ruipgb/Greenhouse-Temperature-LED-Control/Greenhouse-Temperature-LED-Control-Report.pdf

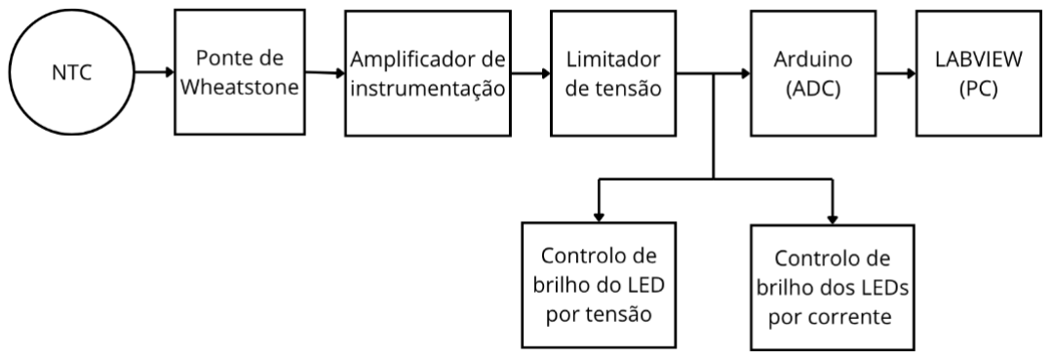
[picture p1: figure]
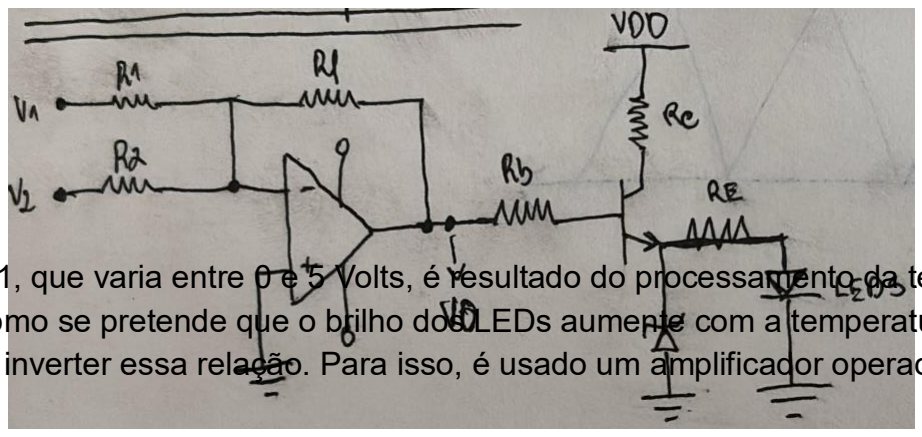
[picture p2: figure]

Figura 2- Circuito de controlo do brilho dos LEDs (controlo por corrente)

Neste relatório irá ser apresentado o desenvolvimento de um sistema de monitorização e controlo da temperatura de uma estufa em que com a alteração da temperatura altera também o brilho de vários LEDs da mesma forma.

Ao longo deste relatório irão ser descritos em separados os vários circuitos utilizados, e expostos por partes, sendo estas partes o dimensionamento, ou seja, os cálculos necessários para concluir os circuitos, a simulação, para verificar o comportamento do circuito de forma segura, experimentação, portanto, os resultados obtidos em laboratório apos a montagem do circuito, e finalmente, a conclusão, onde serão expostas comparações entre as partes anteriormente descritas.

### 2. Diagrama geral

Este projeto está dividido em vários blocos, sendo os novos para este relatório, o controlo de brilho dos LEDs por corrente, onde se inverte e soma ao sinal durante condicionamento de sinal e amplifica-se a corrente, o controlo de brilho do LED por tensão, onde se compara o sinal que sai do amplificador de instrumentação com uma onda triangular para criar uma onda PWM e controlar o seu duty cycle, e finalmente, o LABVIEW, onde ligando o arduino ao PC por porta série pode-se observar um gráfico da temperatura em função do tempo recorrendo às funcionalidades do LABVIEW.

Figura 1 – Diagrama geral

### 3. Controlo de brilho dos LEDs por corrente

a. Circuito adotado

O circuito implementado tem como objetivo controlar o brilho dos LEDs através da regulação da corrente que os atravessa, com base numa tensão de entrada proveniente do Amplificador de instrumentação, designada de VAI = V1.

A tensão V1, que varia entre 0 e 5 Volts, é resultado do processamento da temperatura medida. Como se pretende que o brilho dos LEDs aumente com a temperatura, foi necessário inverter essa relação. Para isso, é usado um amplificador operacional

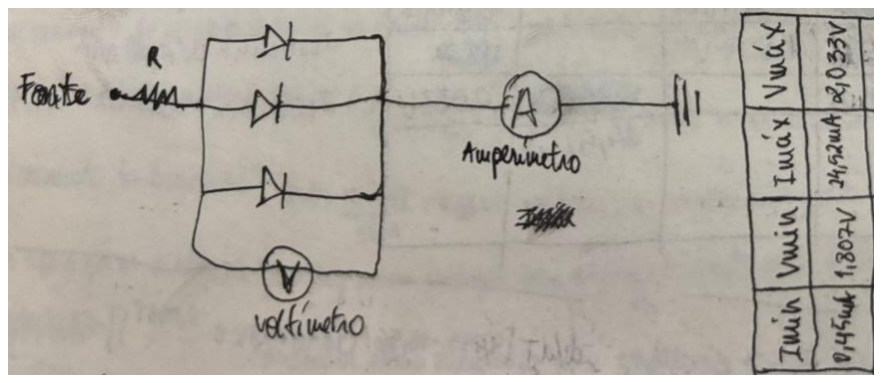
[picture p3: figure]

Figura 3- Circuito de teste e valores medidos

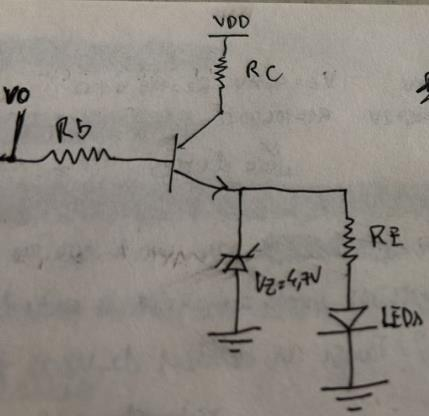
[picture p4: figure]
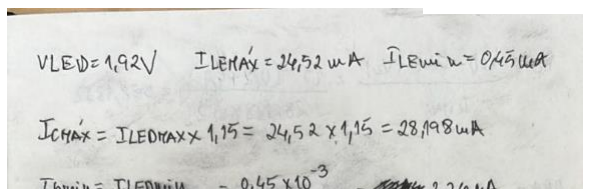
[picture p5: figure]
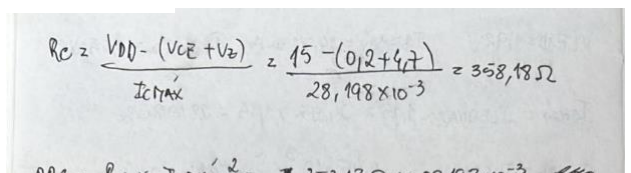
[picture p6: figure]

Figura 4- circuito controlador de corrente

(TL082) em somador inversor, que converte o intervalo [0 V, 5 V] em [V0A = 2,72 V, V0B = 8 V].

A tensão V0 é a tensão de entrada da segunda parte do circuito responsável por controlar a corrente ILED que atravessa os LEDs. Este circuito atua como controlador de corrente, garantindo que a corrente nos LEDs seja proporcional à tensão V0.

À medida que a temperatura aumenta, VAI diminui, o que leva a um aumento de V0 e, consequentemente, da corrente ILED, aumentando o brilho dos LEDs.

b. Análise dos LEDs

Nesta fase, foi medida a corrente mínima (ILEDmin) e a corrente máxima (ILEDmax) em que os LEDs ficavam com pouco brilho e com bastante brilho, respetivamente.

Para isso, foi montado o seguinte circuito de teste e medidos os valores:

Estes valores definem os limites de operação desejados para o circuito principal.

c. Controlador de corrente (Limitador de tensão – amplificação de corrente)
i. Dimensionamento

Com base nos valores medidos para ILEDmin = 0,45 mA e ILEDmax = 24,52 mA, dimensionou-se os componentes do circuito de controlo de corrente.

Esta parte do circuito baseia-se num transístor (BC547), com as resistências, RB base, RE emissor e RC coletor, onde a tensão de entrada V0, varia entre 2,72 V e 8 V.

Cálculos realizados:

Os cálculos permitiram dimensionar os componentes garantindo o funcionamento correto do circuito. Considerando o ganho do transistor e os nossos valores de corrente, foram definidos valores que asseguram uma condução adequada do transístor e o controlo eficaz da corrente nos LEDs. Também foi verificada a de potência nas resistências, de forma a garantir a segurança do circuito. No final, os valores escolhidos para as resistências foram: RC = 360 Ω, RB = 21,3 kΩ e RE = 112 Ω. Estes componentes permitem que a corrente varie entre os limites definidos, proporcionando um controlo estável do brilho dos LEDs em função da tensão de entrada V0.

ii. Simulação

De forma a confirmar todos os cálculos e a montagem do circuito de controlo do brilho dos LEDs por corrente, foram feitas várias simulações, em que o que todas têm em comum é que todas utilizam o mesmo esquema do circuito, esquema este que pode ser visto na seguinte figura.

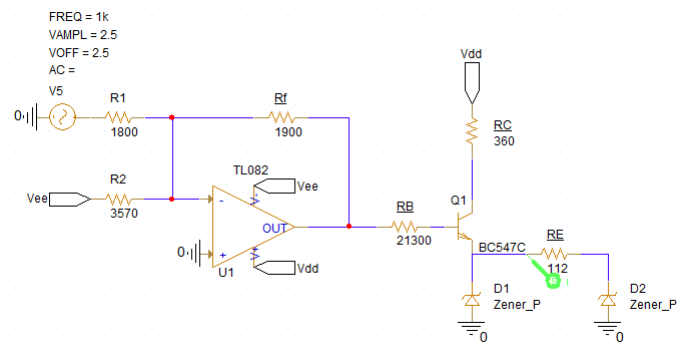
[picture p7: figure]

Figura 7 - circuito de controlo do brilho dos LEDs por corrente no PSpice

A primeira simulação feita foi uma na qual se pretende observar a corrente dos LEDs (ILED) em função da tensão de saída do condicionamento de sinal (V0), ILED=f(V0), podendo ver que e quando aumenta a tensão também aumenta a corrente de forma ampliada, o que é possivel verificar na figura seguinte.

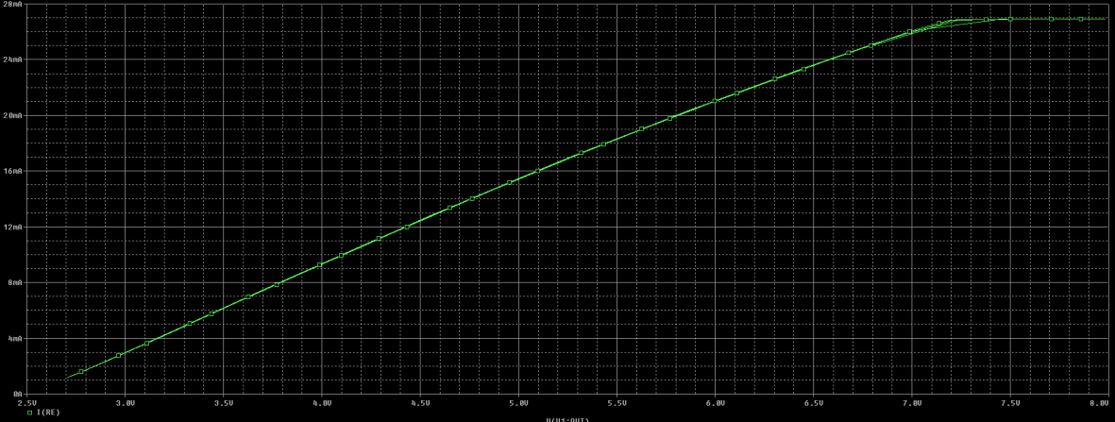
[picture p8: figure]

Figura 8 – Simulação de ILED=f(V0) no PSpice

iii. Experimentação

Para verificar se os LEDs estavam a funcionar como devido alterou-se a tensão de entrada (V0), e mediu-se a corrente e a tensão para quando o brilho dos LEDs era mínimo e máximo. Podendo observar as medições na seguinte figura.

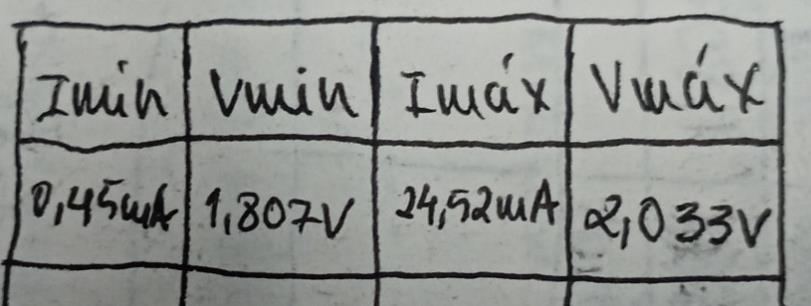
[picture p9: figure]
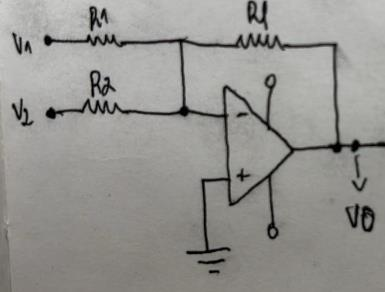
[picture p10: figure]

Figura 10- Circuito condicionamento de sinal

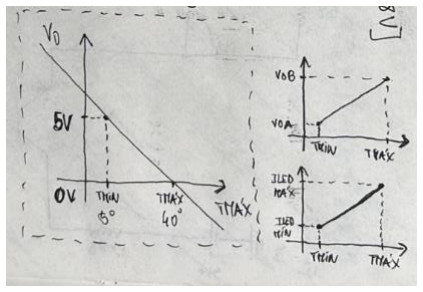
[picture p11: figure]

Figura 11- Gráficos de V1, V0 e ILed vs Temperatura

Figura 9 – Correntes e tensões mínimas e máximas nos LEDs

iv. Conclusão

Através dos cálculos, simulação e experimentação, foi possível verificar que o circuito de controlo de corrente funcionou conforme o esperado. A corrente nos LEDs variou conforme o dimensionado com a tensão V0, o que permitiu controlar o brilho de forma estável e progressiva.

Os valores obtidos na prática foram bastante próximos dos valores teóricos e simulados, validando o dimensionamento dos componentes utilizados. O circuito mostrou-se robusto, sem oscilações, e com um ótimo funcionamento.

d. Circuito de condicionamento de sinal para ajuste da tensão V1 para V0
i. Dimensionamento

Para adaptar a tensão V1, proveniente do amplificador de instrumentação, à tensão V0 necessária para o controlo da corrente nos LEDs, foi utilizado um amplificador operacional em somador inversor.

O objetivo era transformar o intervalo V1 = [5 V, 0 V] no intervalo V0 = [2,72 V, 8 V], de forma a inverter a relação entre temperatura e a tensão: quanto mais alta a temperatura, menor o V1, e maior o V0 → maior brilho dos LEDs.

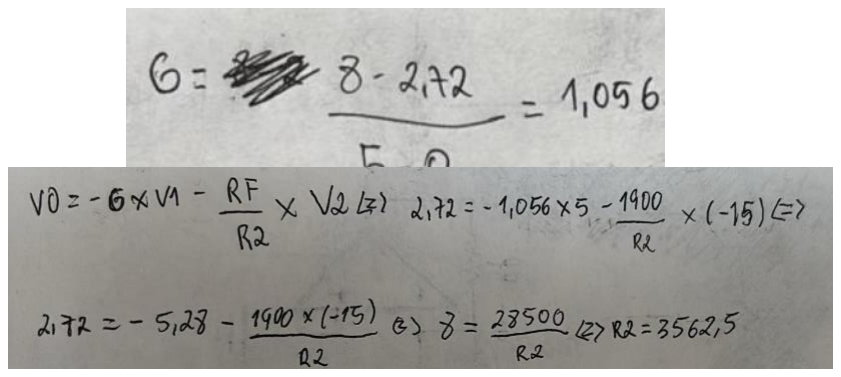
[picture p12: figure]

Figura 12- Cálculos condicionamento de sinal parte 2

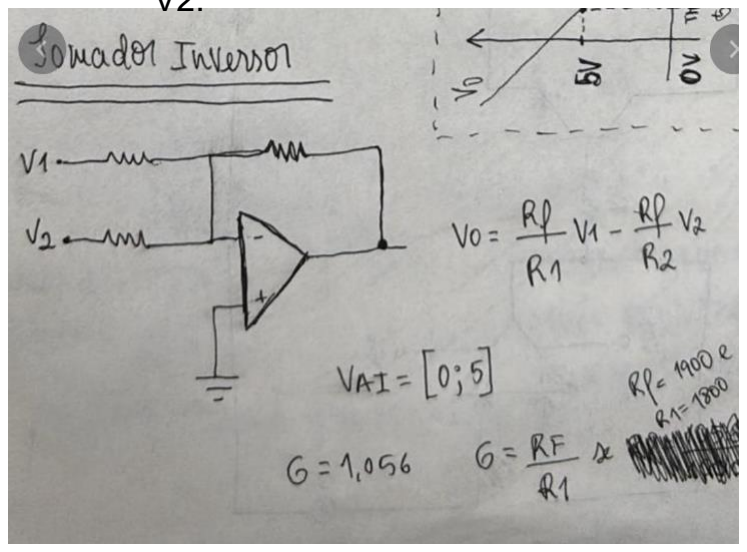
[picture p13: figure]

Figura 13- Cálculos condicionamento de sinal parte 1

A equação usada para calcular a tensão de saída foi, V0= − (R1/RF) x V1 − (R2/RF) x V2.

Estes valores permitem obter a função linear necessária para converter V1 em V0, com o comportamento desejado. Assim, foi possível condicionar o sinal de entrada para controlar a corrente dos LEDs.

ii. Simulação

De forma a ter certeza, de que o dimensionamento do circuito de condicionamento de sinal está correto, fez-se uma simulação para observar a tensão de saída do condicionamento de sinal (V0) em função da tensão de entrada do circuito (V1), conseguindo então verificar o funcionamento do amplificador inversor somador, V0=f(V1), como é possível visualizar na figura seguinte.

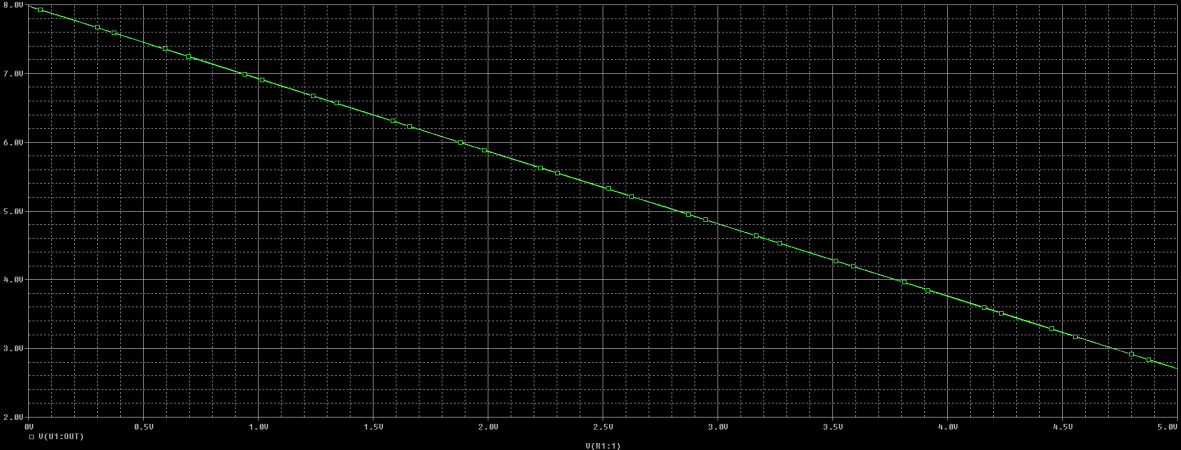
[picture p14: figure]

Figura 14 – Simulação de V0=f(V1) no PSpice

iii. Experimentação

Para verificar que o circuito está correto e que, como pretendido, quando a tensão do amplificador de instrumentação (V1) aumenta, a tensão à saída do condicionamento de sinal (V0) diminui, ligou-se as duas pontas de provas nas respetivas saídas, e colocou-se o osciloscópio e, moo XY, de forma a observar o gráfico V0=f(V1), como é possível observar na seguinte figura.

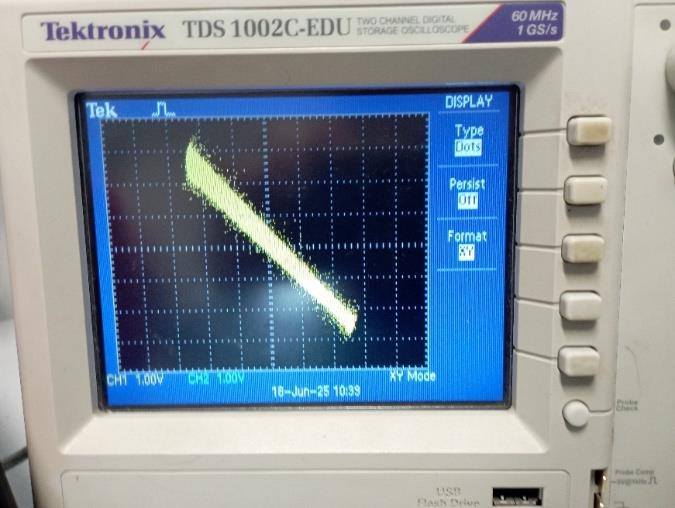
[picture p15: figure]

Figura 15 - V0=f(V1) no osciloscópio em modo XY

iv. Conclusão

A análise do circuito de condicionamento de sinal confirmou que a conversão de V1 para V0 foi realizada com sucesso. Os cálculos teóricos permitiram definir os resistores do somador inversor de forma a obter a gama desejada de saída, com ganho e offset ajustados corretamente.

A simulação validou o comportamento esperado, mostrando uma relação linear e invertida entre V1 e V0. Experimentalmente, foi possível confirmar essa relação utilizando o osciloscópio em modo XY, onde se observou uma reta descendente, tal como previsto.

Assim, conclui-se que o circuito permite ajustar corretamente o sinal de entrada, garantindo o controlo adequado da corrente nos LEDs.

e. Funcionamento do circuito completo
i. Simulação

Para verificar se os LEDs alteram o brilho como previsto após montar o circuito inteiro, fez-se uma simulação em que se visualiza a corrente nos LEDs (ILED) em função da tensão de entrada (V1), ILED=f(V1), como se pode observar figura seguinte.

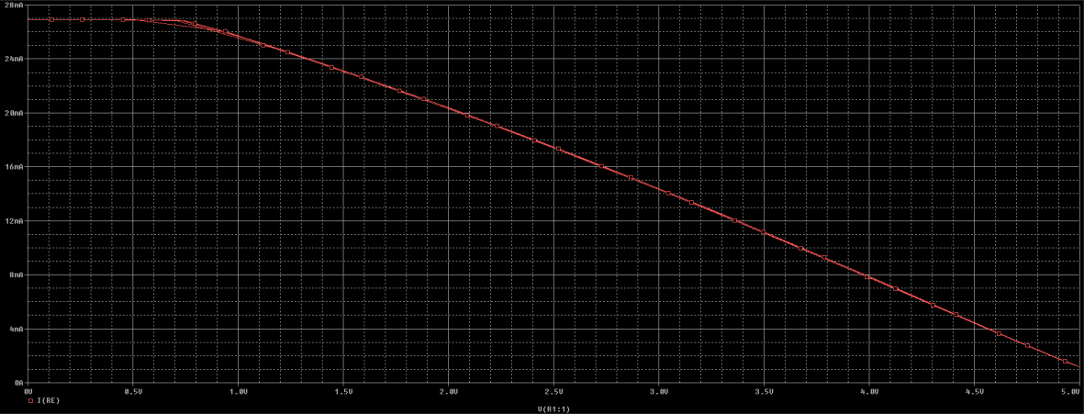
[picture p16: figure]

Figura 16 – Simulação de ILED=f(V1) no PSpice

ii. Experimentação

De forma a ter certeza de que os LEDs estão a mudar o brilho como desejado e que as tensões também são as desejadas isolou-se o circuito, colocando no ponto onde estaria a saída do amplificador de instrumentação, ou seja na entrada deste circuito (V1), colocou-se uma fonte de 5 V e verificou-se que os LEDs estavam desligados, de seguida retirou-se essa fonte, e os LEDs ligaram-se com o brilho máximo, exatamente como desejado. Podendo verificar as medições da tensão de saída do condicionamento de sinal (V0) e o brilho dos LEDs nas seguintes figuras.

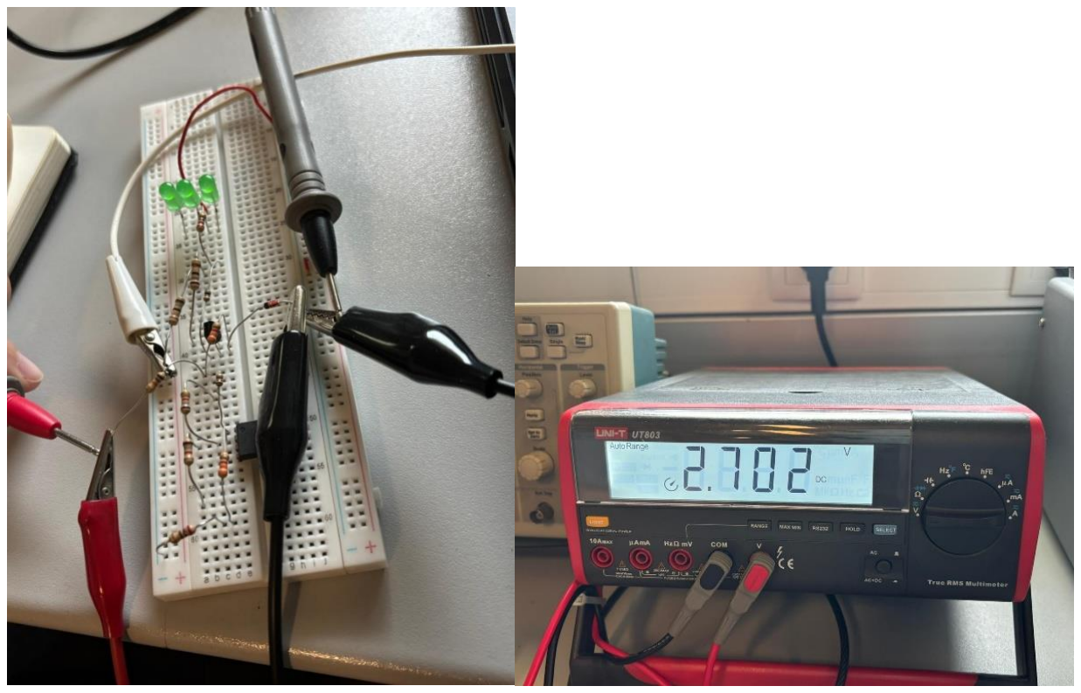
[picture p17: figure]

Figura 17 – Montagem do circuito quando V1=5V | Figura 18 – V0 quando
V1=5V

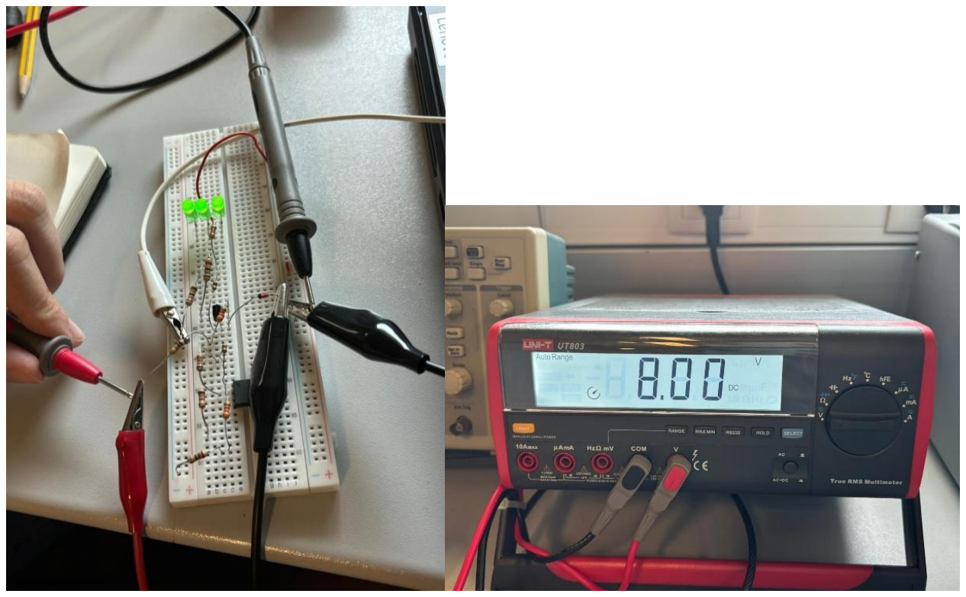
[picture p18: figure]
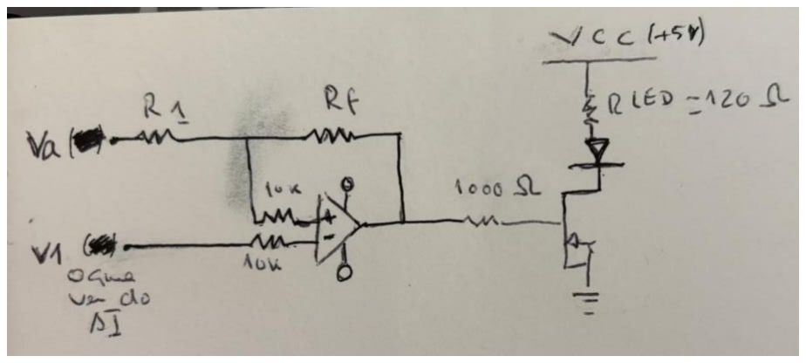
[picture p19: figure]

Figura 21- Circuito Schmitt trigger

Figura 19 - Montagem do circuito quando V1=0V | Figura 20 - V0 quando
V1=0V

iii. Conclusão

Com os dois circuitos juntos controlou-se corretamente a corrente nos LEDs em função da tensão V₁. O brilho variou de forma estável e progressiva, confirmando que o sistema se comporta conforme os cálculos e simulações realizados.
Em suma, o circuito respondeu adequadamente às variações de temperatura, cumprindo o objetivo do controlo de brilho.

### 4. Controlo de brilho do LED por tensão

a. Circuito Schmitt trigger
i. Dimensionamento

O circuito Schmitt Trigger foi utilizado para gerar o sinal PWM que controla o brilho dos LEDs. Este sinal é obtido comparando uma onda triangular (Va) com a tensão de controlo V1, proveniente do amplificador de instrumentação. A principal vantagem da utilização do Schmitt Trigger é a introdução de histerese, evitando comutações indesejadas quando Va se aproxima de V1.

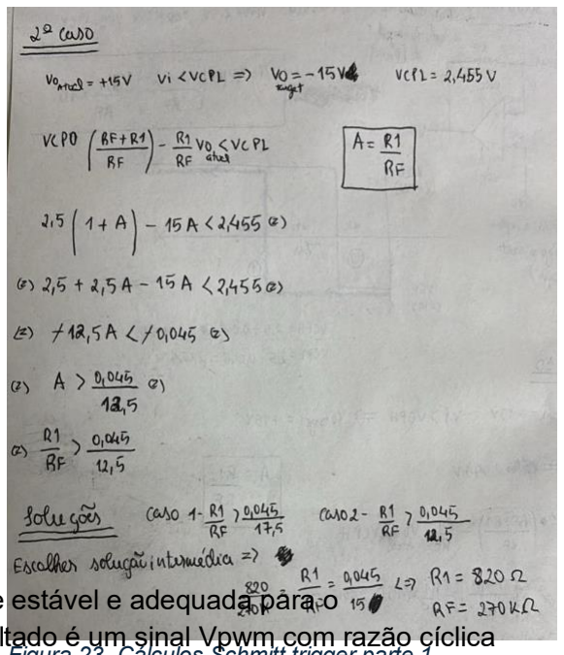
[picture p20: figure]
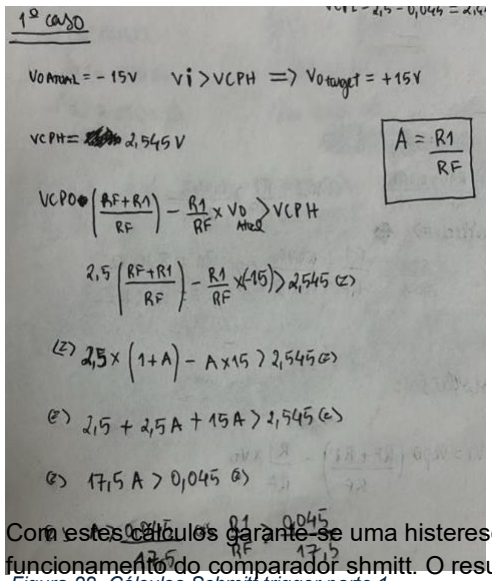
[picture p21: figure]

Figura 22- Cálculos Schmitt trigger parte 1 | Figura 23- Cálculos Schmitt trigger parte 1

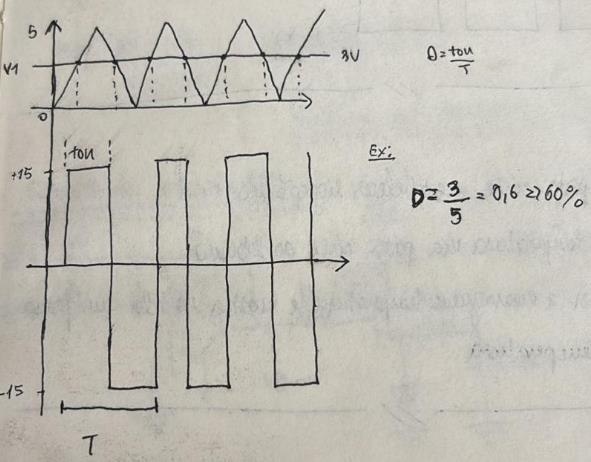
[picture p22: figure]

Figura 24- Exemplo do sinal PWM gerado

O comportamento do circuito foi analisado utilizando a seguinte equação, Vi = VCPO x ((RF+R1)/ RF) – (R1/RF) x V0

Com estes cálculos garante-se uma histerese estável e adequada para o funcionamento do comparador shmitt. O resultado é um sinal Vpwm com razão cíclica variável em função da temperatura, usado para controlar o brilho dos LEDs por modulação por largura de impulso (PWM).

ii. Simulação

De forma a testar o circuito antes de o implementar em laboratório, de forma a diminuir os riscos de uma má montagem esta foi feita previamente no PSpice. Começou-se por desenhar o esquema do circuito, esquema este que pode ser visualizado na próxima figura.

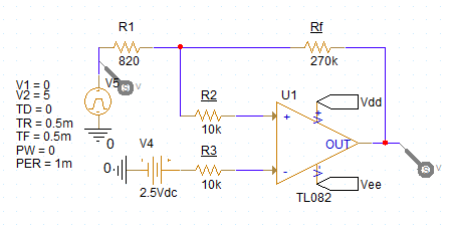
[picture p23: figure]

Figura 25 – Circuito do comparador Schmitt trigger no PSpice

Em seguida fez-se uma simulação em que se tem a tensão te saída (Vpwm) em função da tensão de entrada (V1), podendo então observar a função de transferência Vpwm=f(V1) na figura seguinte.

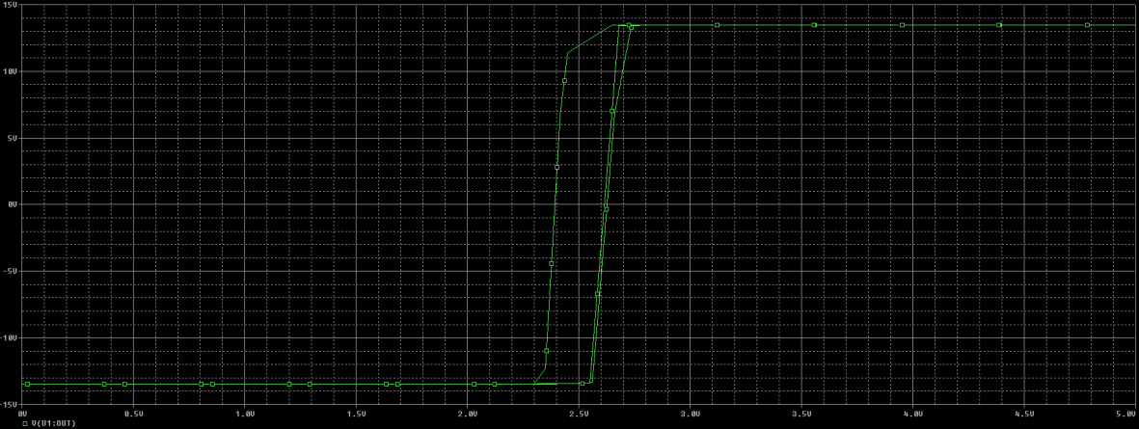
[picture p24: figure]

Figura 26 – Simulação de Vpwm=f(V1) no PSpice

Fez-se também uma simulação no domínio do tempo (transiente) em que se pode observar, em simultâneo, a onda triangular e a onda PWM, como se pode ver na seguinte figura.

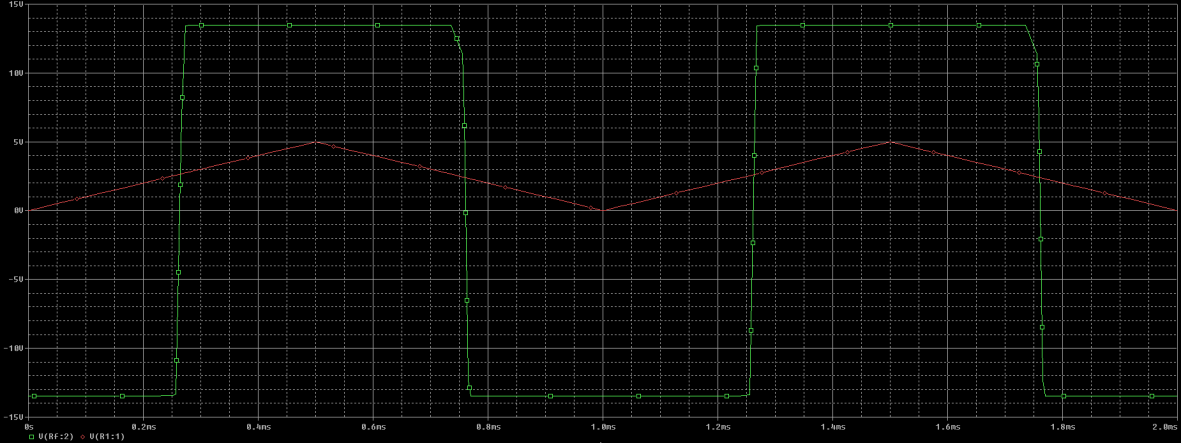
[picture p25: figure]

Figura 27 – Simulação das ondas triangular e PWM no PSpice

iii. Experimentação

Para verificar o correto funcionamento do circuito, mais concretamente, verificar se a histerese funciona como previsto, isolou-se o circuito, e onde estaria a saída do amplificador de instrumentação colocou-se 2,5 V e no local da onda triangular foi introduzida uma onda sinusoidal de amplitude de cerca de 2,5 vezes a histerese (V1), e verificou-se que é criada a onda PWM (Vpwm). Em seguida, foi colocado o osciloscópio em modo XY, para observar a histerese, visualizando então o gráfico Vpwm=f(V1). Conseguindo então observar as ondas sinusoidal e PWM, assim como a histerese nas seguintes figuras.

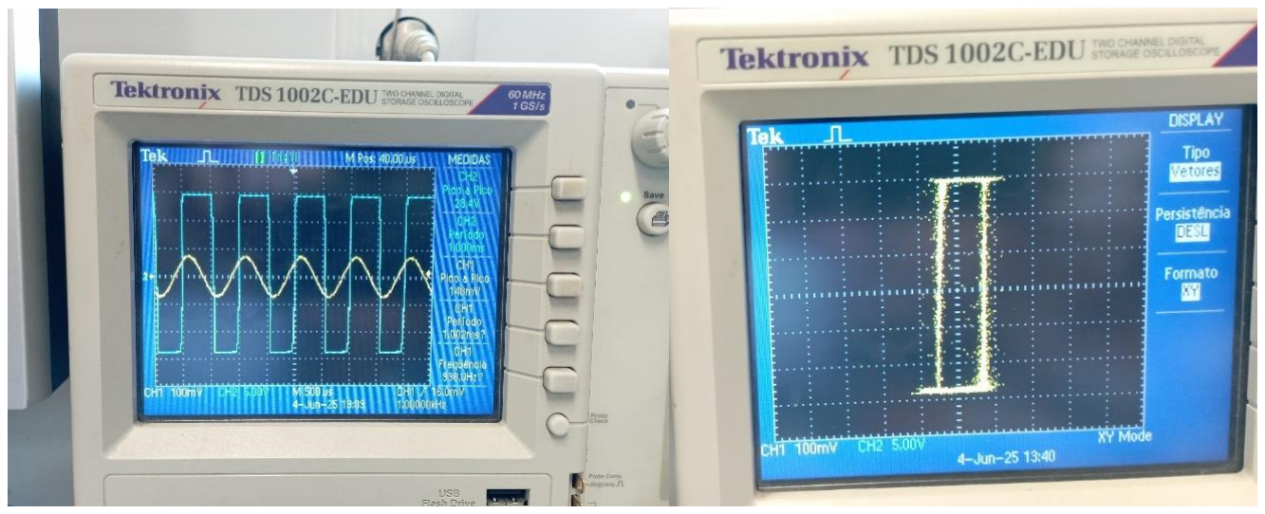
[picture p26: figure]

Figura 28 – Visualização das ondas sinusoidal e PWM Figura 29 – Visualização da histerese em modo XY

iv. Conclusão

Após a realização dos cálculos, simulação e experimentação do circuito Schmitt Trigger, concluiu-se que o seu funcionamento está de acordo com o previsto. Através dos cálculos, foi possível determinar os pontos de comutação superiores e inferiores (VCPH e VCPL), garantindo uma histerese adequada ao funcionamento pretendido.

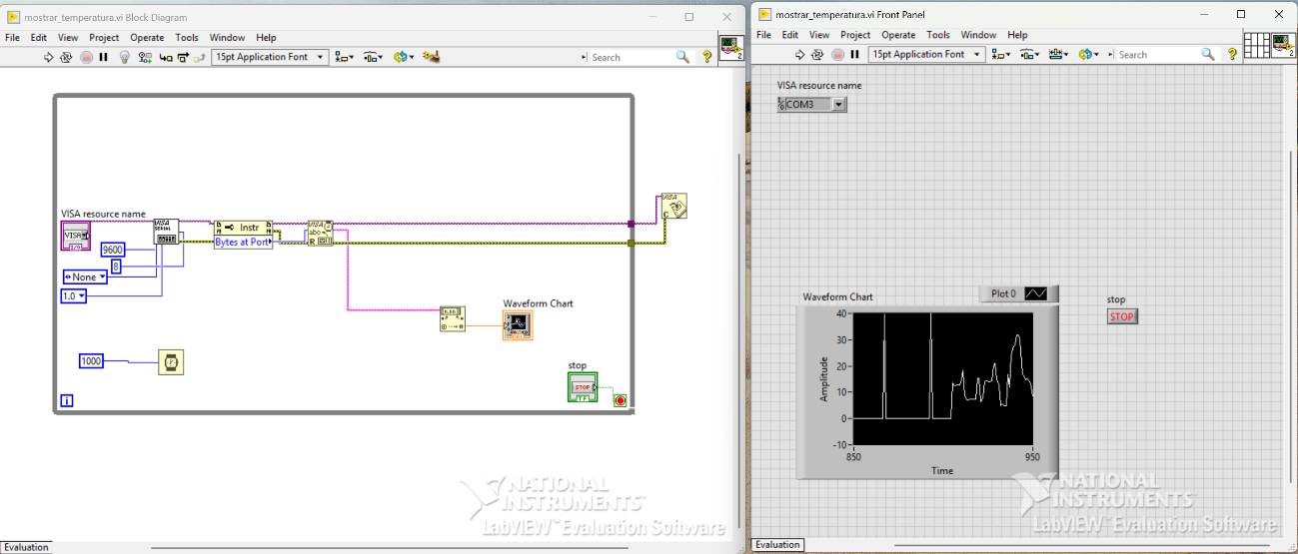
[picture p27: figure]

Figura 30- Programa desenvolvido em LabVIEW para visualização da temperatura

A simulação confirmou os valores teóricos, validando a escolha das resistências R1 e RF. Experimentalmente, utilizando o osciloscópio em modo XY, observou-se a variação correta do sinal Vpwm em função da tensão triangular Va e da referência V1, demonstrando que o circuito comuta entre os dois níveis de saída com estabilidade.

A razão cíclica do sinal PWM variou como esperado com a alteração de V1, o que permite controlar o brilho dos LEDs de forma eficaz. Não foram observadas oscilações indesejadas nas transições, confirmando que a histerese introduzida é suficiente para garantir um bom funcionamento do sistema.

### 5. Utilização do LabVIEW para mostrar a temperatura

Para visualizar a temperatura medida no sistema, foi utilizado o LabVIEW. Como já existia um programa previamente desenvolvido em Arduino, que enviava os dados da temperatura através da porta Serial com Serial.println(), foi criado um programa em LabVIEW para receber e representar esses dados em tempo real.

O programa desenvolvido em LabVIEW utiliza o bloco VISA para estabelecer comunicação serial com o Arduino. Os dados recebidos são lidos, convertidos e apresentados num gráfico do tipo "Waveform Chart", que permite acompanhar a evolução da temperatura ao longo do tempo.

Esta aplicação mostrou-se funcional e eficaz na visualização da variável temperatura, permitindo validar visualmente o comportamento do sistema em tempo real.

### 6. Circuito final

Após o teste de todos os circuitos de forma isolada, juntou-se todos os circuitos, e, substituindo o NTC por um potenciómetro para simular a sua resistência, confirmou-se que todos os circuitos funcionavam como previsto, verificando a mudança de brilho dos vários LEDs com a alteração da resistência do potenciómetro, e observando também o gráfico no PC com a alteração devida da temperatura quando se altera também a resistência do potenciómetro. As seguintes figuras mostram os circuitos todos ligados entre si.

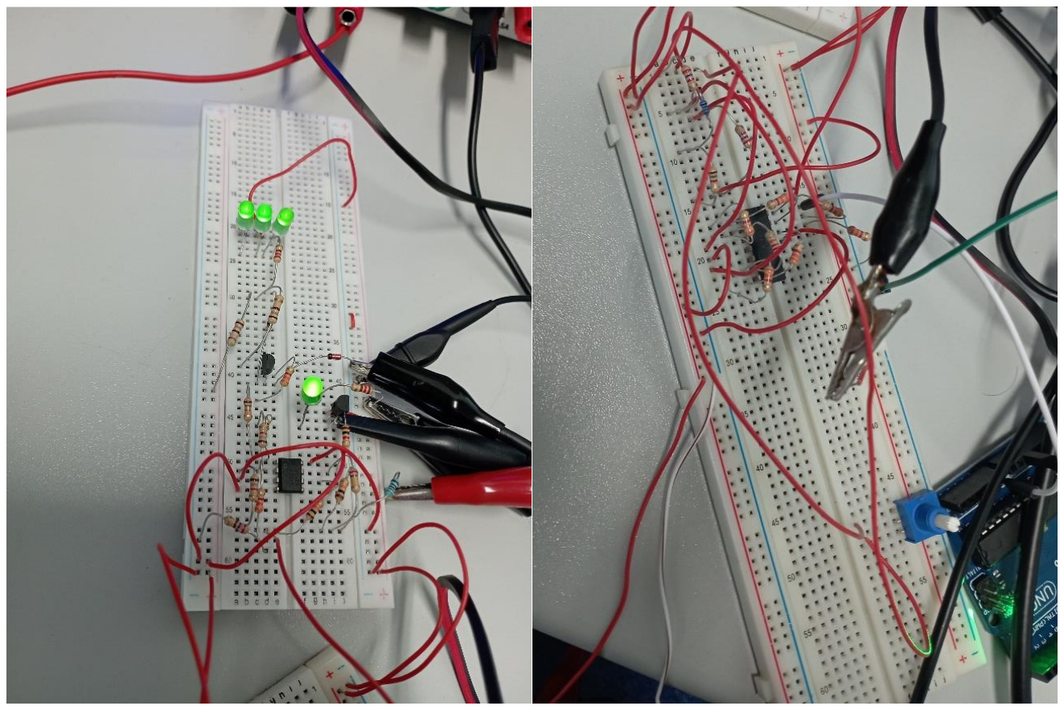
[picture p28: figure]

Figura 31 – Montagem dos circuitos de controlo de brilho Figura 32 – Montagem do circuito previamente feito

### 7. Conclusão

Ao longo do projeto foram implementados dois circuitos diferentes de controlo do brilho dos LEDs: um baseado no controlo da corrente e outro através de modulação por largura de impulso (PWM).

Comparando os dois circuitos, o controlo por corrente apresenta uma resposta mais linear e previsível, enquanto o controlo por PWM é mais eficiente e permite uma implementação mais simples com menos componentes.

Ambos os circuitos funcionaram bem, permitiram ajustar o brilho dos LEDs em função da temperatura. Embora não tenham surgido problemas relevantes durante a execução do projeto, a implementação prática validou todos os cálculos e simulações efetuados. Em suma os objetivos propostos foram atingidos.
