ruipgb/Greenhouse-Temperature-LED-Control/Simulações/circuito comparador/CIRCUITO COMPARADOR.png

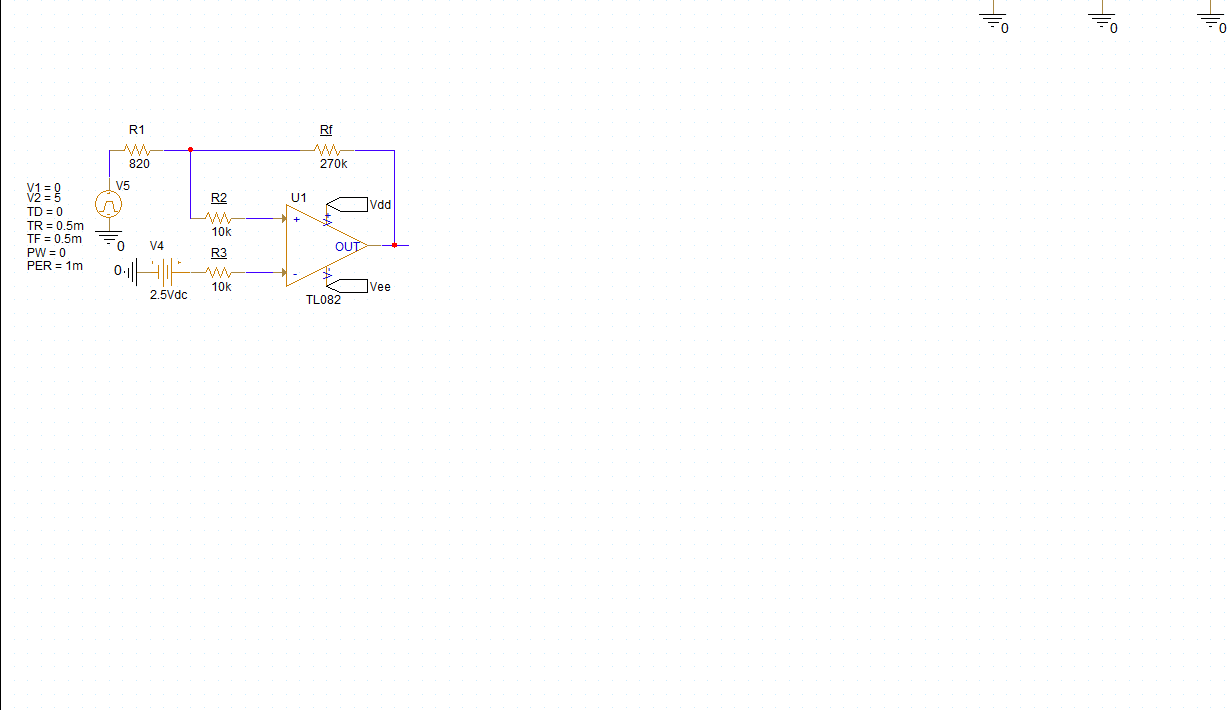
Simulações/circuito comparador/CIRCUITO COMPARADOR.png
