ruipgb/Greenhouse-Temperature-LED-Control/Simulações/Circuito LEDs/CIRCUITO LEDS.png

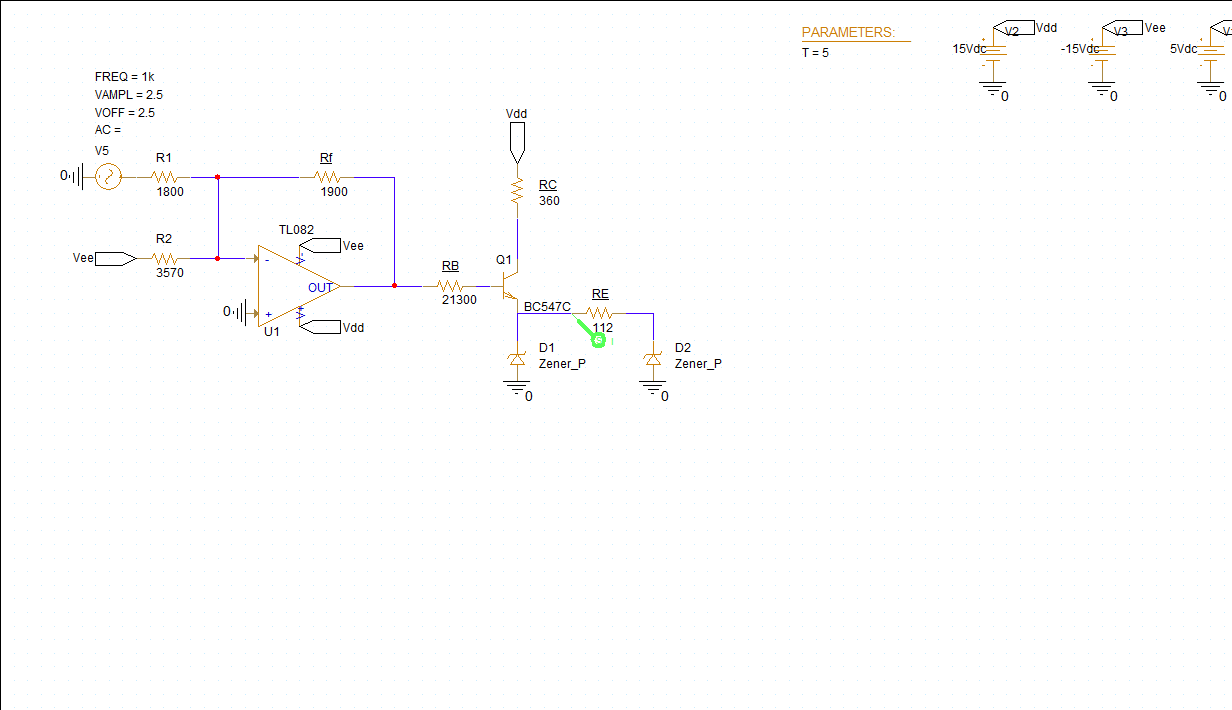
Simulações/Circuito LEDs/CIRCUITO LEDS.png
