ruipgb/Greenhouse-Temperature-LED-Control/Simulações/circuito comparador/circuito comparador-PSpiceFiles/SCHEMATIC1/simulação comparador/simulação comparador.cir

** Profile: "SCHEMATIC1-simulação comparador"  [ c:\cds_spb_home\cdssetup\projects\circuito comparador\circuito comparador-pspicefiles\schematic1\simulação comparador.sim ] 

** Creating circuit file "simulação comparador.cir" 
** WARNING: THIS AUTOMATICALLY GENERATED FILE MAY BE OVERWRITTEN BY SUBSEQUENT SIMULATIONS

*Libraries: 
* Profile Libraries :
* Local Libraries :
* From [PSPICE NETLIST] section of C:\cds_spb_home\cdssetup\OrCAD_PSpiceTIPSpice_Install\23.1.0\PSpice.ini file:
.lib "nom_pspti.lib" 
.lib "nom.lib" 

*Analysis directives: 
.TRAN  0 2m 0 
.OPTIONS ADVCONV
.OPTIONS FILEMODELSEARCH
.PROBE64 V(alias(*)) I(alias(*)) W(alias(*)) D(alias(*)) NOISE(alias(*)) 
.INC "..\SCHEMATIC1.net" 


.END
