ruipgb/Greenhouse-Temperature-LED-Control/Simulações/Circuito LEDs/Circuito LEDs-PSpiceFiles/SCHEMATIC1/Simulaçao LEDs/Simulaçao LEDs.cir

** Profile: "SCHEMATIC1-Simulaçao LEDs"  [ C:\cds_spb_home\cdssetup\projects\Circuito LEDs\circuito leds-pspicefiles\schematic1\simulaçao leds.sim ] 

** Creating circuit file "Simulaçao LEDs.cir" 
** WARNING: THIS AUTOMATICALLY GENERATED FILE MAY BE OVERWRITTEN BY SUBSEQUENT SIMULATIONS

*Libraries: 
* Profile Libraries :
* Local Libraries :
* From [PSPICE NETLIST] section of C:\cds_spb_home\cdssetup\OrCAD_PSpiceTIPSpice_Install\23.1.0\PSpice.ini file:
.lib "nom_pspti.lib" 
.lib "nom.lib" 

*Analysis directives: 
.TRAN  0 2ms 0 
.OPTIONS ADVCONV
.OPTIONS FILEMODELSEARCH
.PROBE64 V(alias(*)) I(alias(*)) W(alias(*)) D(alias(*)) NOISE(alias(*)) 
.INC "..\SCHEMATIC1.net" 


.END
