ruipgb/Greenhouse-Temperature-LED-Control/(list of files, drawings)

Other design files:
Simulações/circuito comparador/CIRCUITO COMPARADOR.DSN
Simulações/circuito comparador/circuito comparador.opj
Simulações/Circuito LEDs/CIRCUITO LEDS.DSN
Simulações/Circuito LEDs/Circuito LEDs.opj
